vidalperezbohoyo/g-arm/documentation/electronics.png

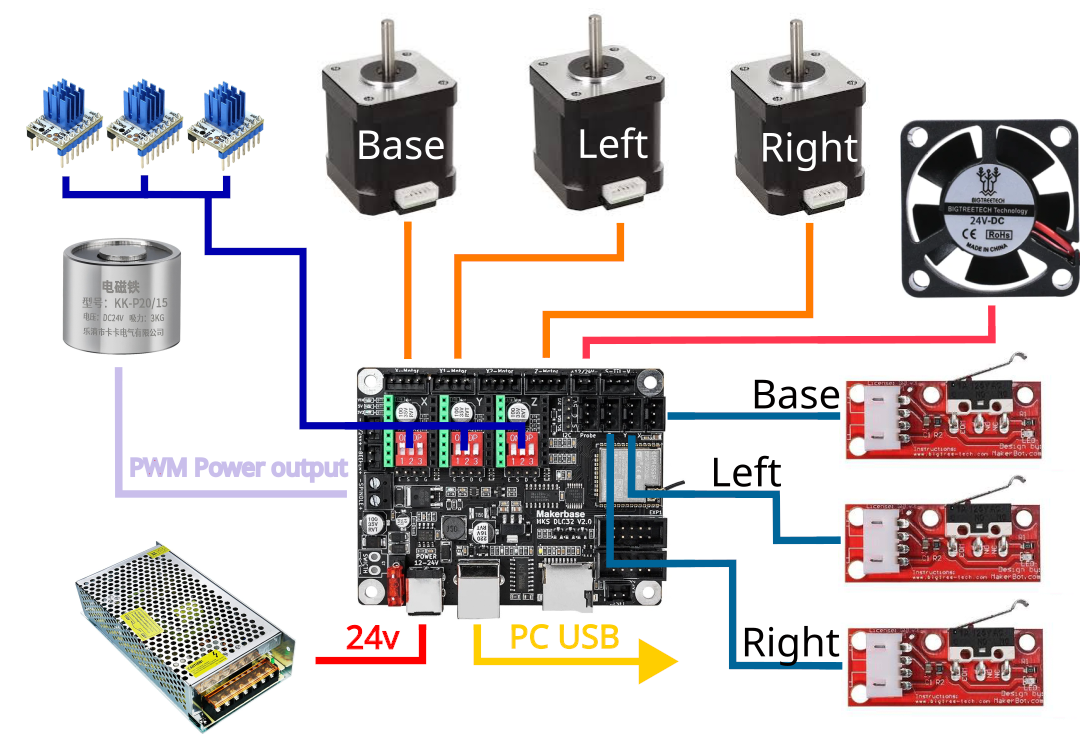
documentation/electronics.png
