vidalperezbohoyo/g-arm/documentation/motors_names.png

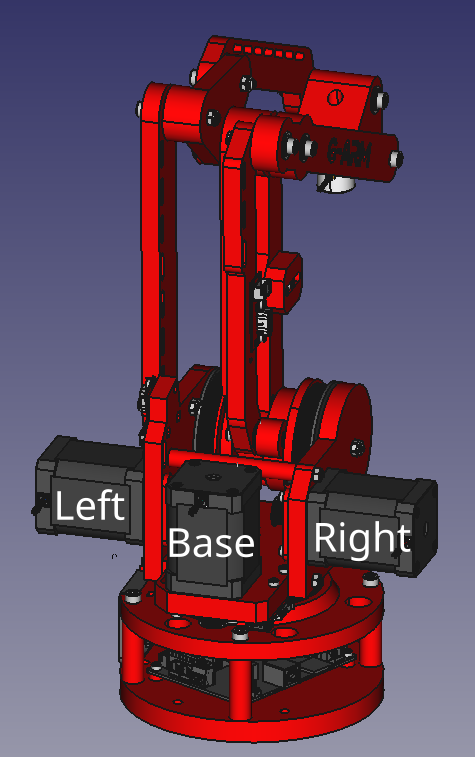
documentation/motors_names.png
