vidalperezbohoyo/g-arm/documentation/wiki_images/trajectories.png

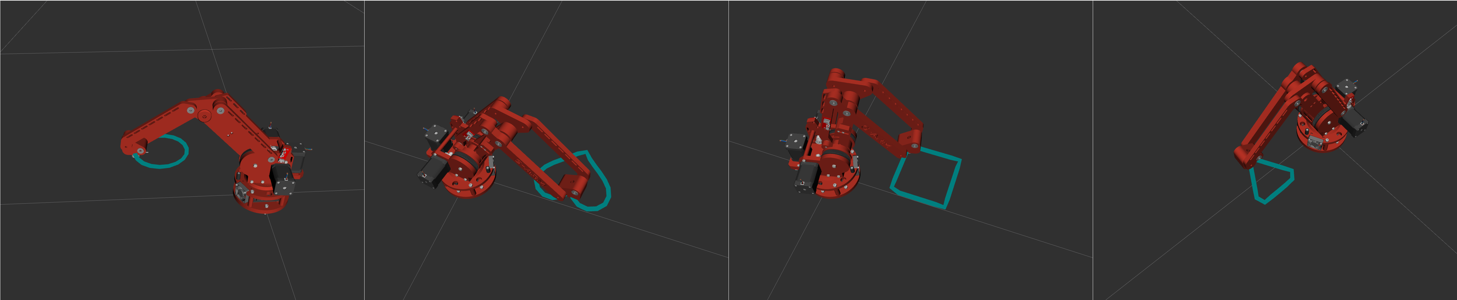
documentation/wiki_images/trajectories.png
