vidalperezbohoyo/g-arm/hardware/FreeCad/#0_ASSEMBLY_ELECTROMAGNET.FCStd

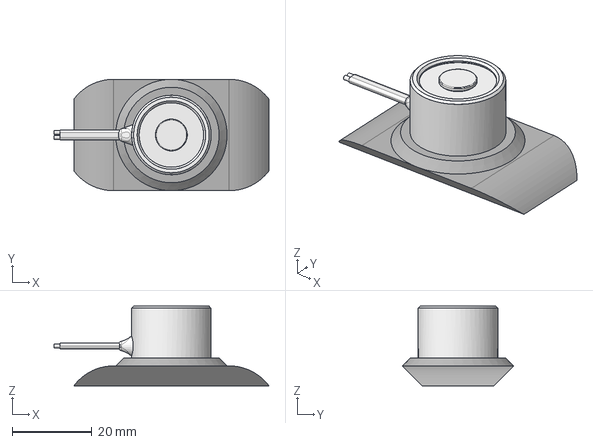
[picture p10: CAD file, 2026-05-24]
hardware/FreeCad/#0_ASSEMBLY_ELECTROMAGNET.FCStd
54.0 x 28.0 x 20.0 mm
#23_TOOL_Electromagnet_001
electromagnet1_001
