vidalperezbohoyo/g-arm/hardware/FreeCad/#0_ASSEMBLY_MAIN_BASE.FCStd

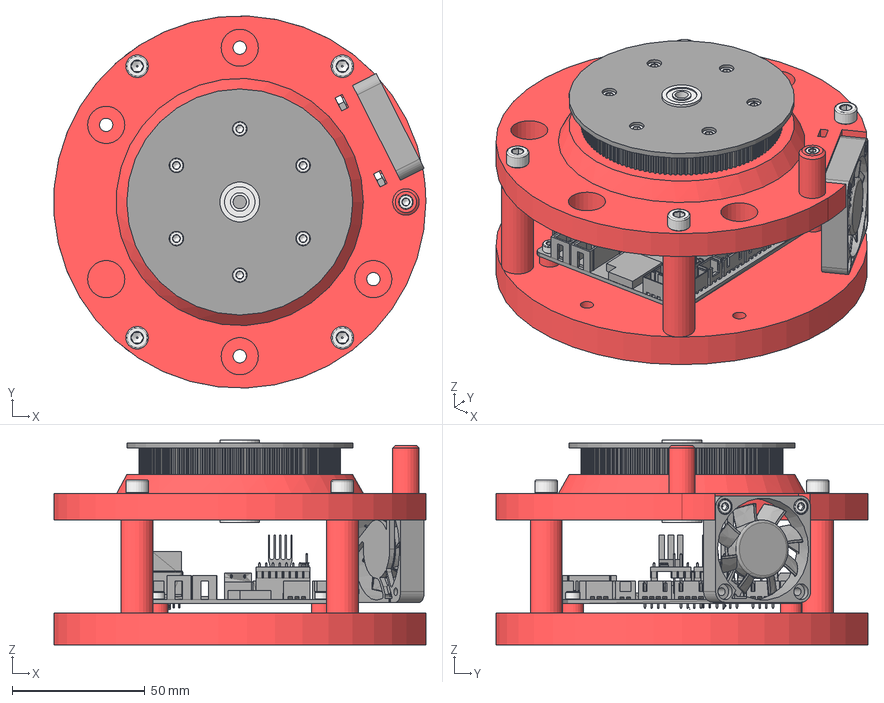
[picture p11: CAD file, 2026-05-24]
hardware/FreeCad/#0_ASSEMBLY_MAIN_BASE.FCStd
139.8 x 139.9 x 77.0 mm
#1_BaseFloor_001
#2_BaseSpacers_001
#3_BaseTop_001
#2_BaseSpacers_002
#2_BaseSpacers_003
#2_BaseSpacers_004
4010Fan
#4_BasePulley120T_001
M3x25-Tornillo
M3x25-Tornillo018
M3x25-Tornillo019
M3x25-Tornillo020
M3x25-Tornillo021
M3x25-Tornillo022
M5x50-Tornillo
M5x50-Tornillo007
M5x50-Tornillo008
M5x50-Tornillo009
M3x16-Tornillo
M3x16-Tornillo001
#6_BaseRotationLimit_001
M3x25-Tornillo023
Mks1_001
F6951_001
F6951_002
M3x12-Tornillo
M3x12-Tornillo013
M3x12-Tornillo014
M3x12-Tornillo015
M3-Tuerca
M3-Tuerca001
M3-Tuerca002
M3-Tuerca003
M3-Tuerca004
M3-Tuerca005
M3-Tuerca006
M3-Tuerca015
M3-Tuerca016
