vidalperezbohoyo/g-arm/hardware/FreeCad/#0_ASSEMBLY_END_EFFECTOR.FCStd

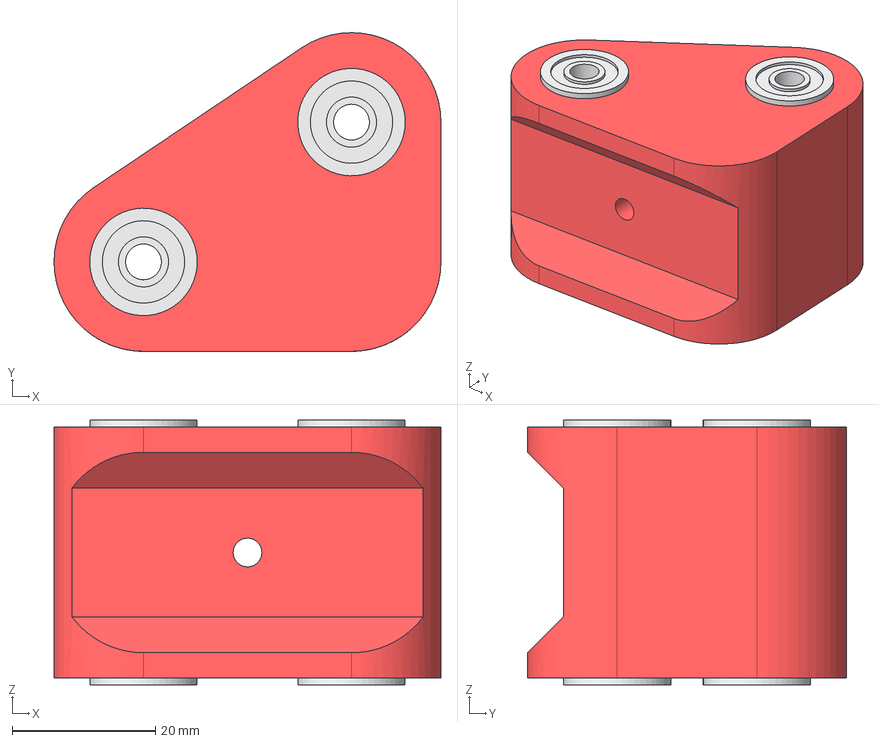
[picture p14: CAD file, 2026-05-24]
hardware/FreeCad/#0_ASSEMBLY_END_EFFECTOR.FCStd
54.1 x 44.5 x 37.0 mm
#21_EndEffector_001
F6951_001
F6951_002
F6951_003
F6951_004
