vidalperezbohoyo/g-arm/hardware/Complements/F695.step

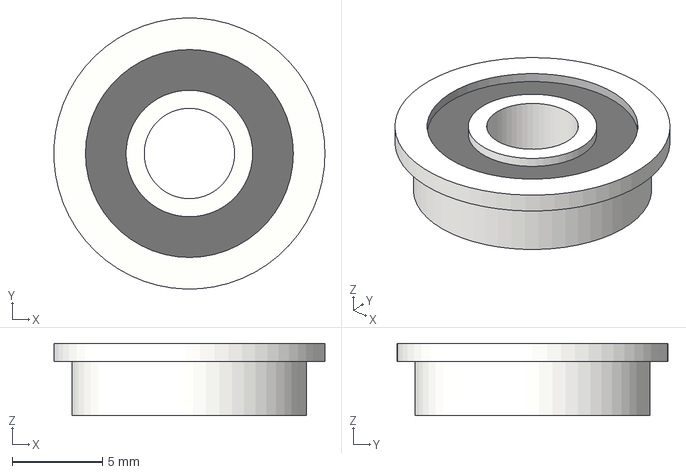
[picture p15: CAD file, 2023-10-28]
hardware/Complements/F695.step
15.0 x 15.0 x 4.00 mm
