vidalperezbohoyo/g-arm/hardware/FreeCad/#20_Link2Parallel.FCStd

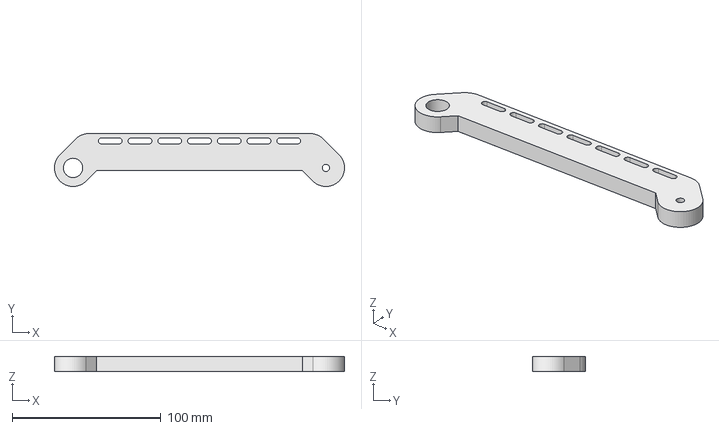
[picture p16: CAD file, 2026-05-24]
hardware/FreeCad/#20_Link2Parallel.FCStd
195.0 x 35.6 x 10.0 mm
