vidalperezbohoyo/g-arm/ros2/g_arm_description/meshes/link_j3_lever.stl

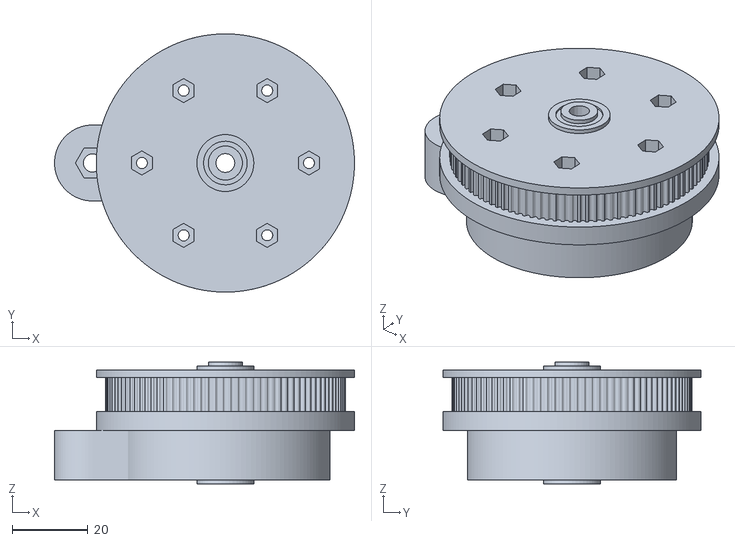
[picture p17: CAD file, 2023-10-28]
ros2/g_arm_description/meshes/link_j3_lever.stl
79.0 x 68.0 x 32.0
