vidalperezbohoyo/g-arm/hardware/Complements/GT2_20T.step

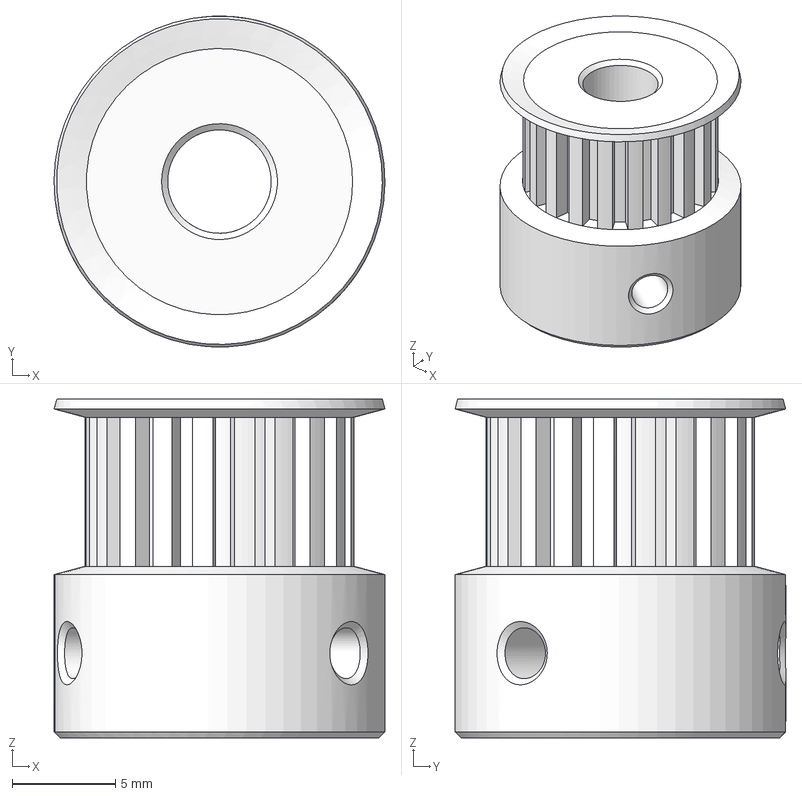
[picture p18: CAD file, 2023-10-28]
hardware/Complements/GT2_20T.step
16.0 x 16.0 x 16.4 mm
