vidalperezbohoyo/g-arm/hardware/FreeCad/#11_Link1.FCStd

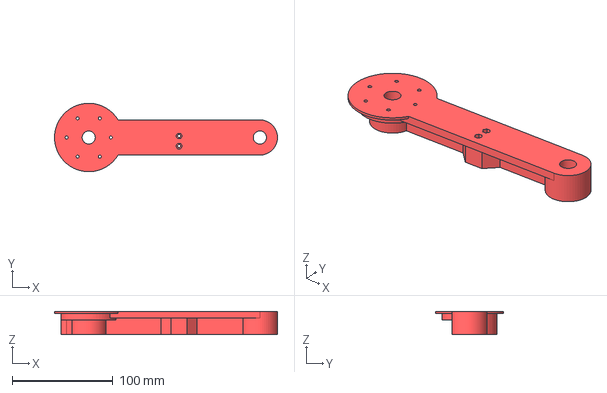
[picture p19: CAD file, 2026-05-24]
hardware/FreeCad/#11_Link1.FCStd
221.5 x 67.9 x 23.0 mm
