vidalperezbohoyo/g-arm/ros2/g_arm_description/meshes/link1.stl

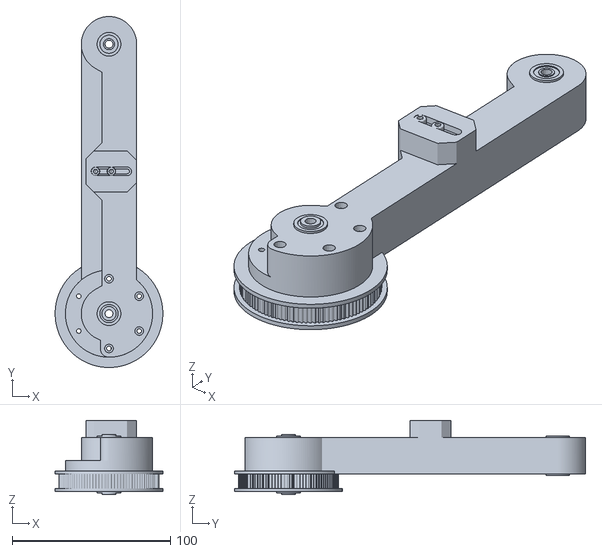
[picture p20: CAD file, 2023-10-28]
ros2/g_arm_description/meshes/link1.stl
68.0 x 221.5 x 47.0
