vidalperezbohoyo/g-arm/ros2/g_arm_description/meshes/link_j3_rod.stl

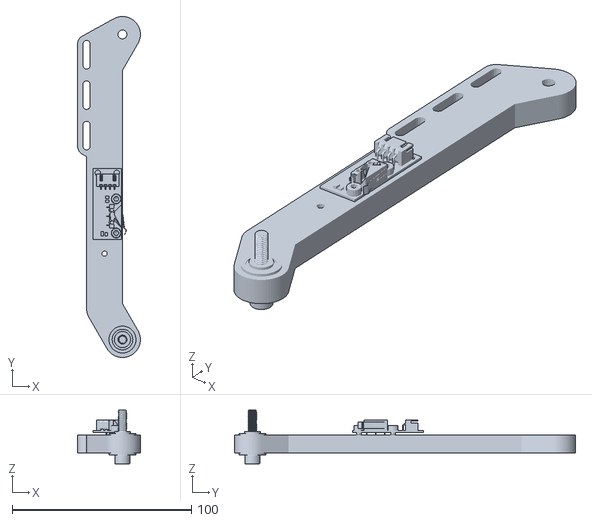
[picture p22: CAD file, 2023-10-28]
ros2/g_arm_description/meshes/link_j3_rod.stl
35.0 x 190.0 x 30.0
