vidalperezbohoyo/g-arm/hardware/Complements/Endstop.step

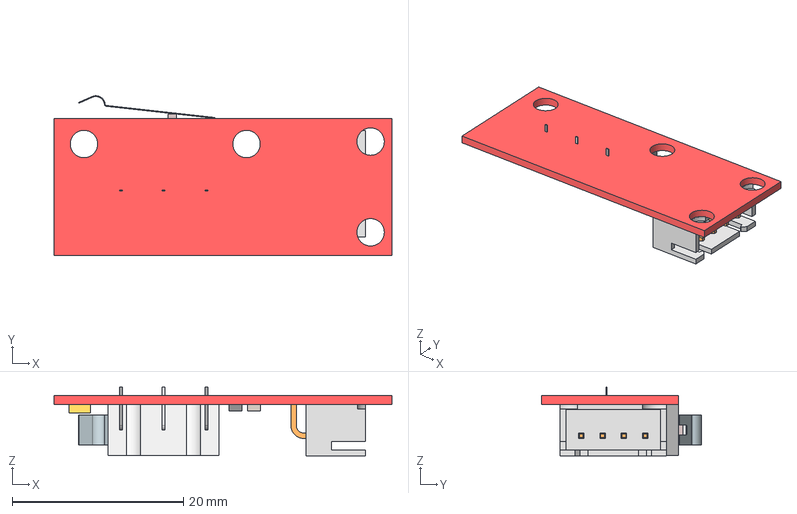
[picture p23: CAD file, 2023-10-28]
hardware/Complements/Endstop.step
39.5 x 18.6 x 8.02 mm
PCB Geometry
PCB^Endstop
Microswitch_1A_125vAC(seul)
JST 4Pin
