vidalperezbohoyo/g-arm/hardware/FreeCad/#17_Elbow.FCStd

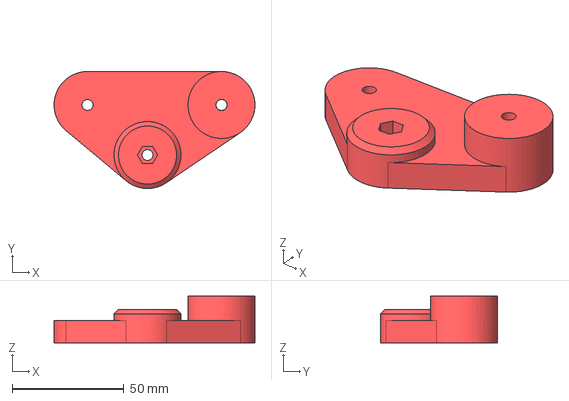
[picture p24: CAD file, 2026-05-24]
hardware/FreeCad/#17_Elbow.FCStd
90.0 x 52.4 x 21.0 mm
