vidalperezbohoyo/g-arm/ros2/g_arm_description/meshes/end.stl

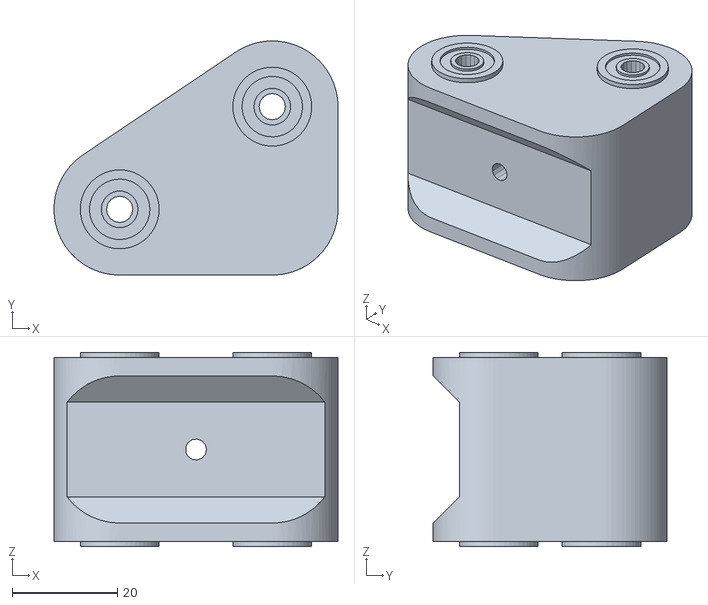
[picture p25: CAD file, 2023-10-28]
ros2/g_arm_description/meshes/end.stl
54.0 x 44.5 x 37.0
