vidalperezbohoyo/g-arm/hardware/Complements/electromagnet.step

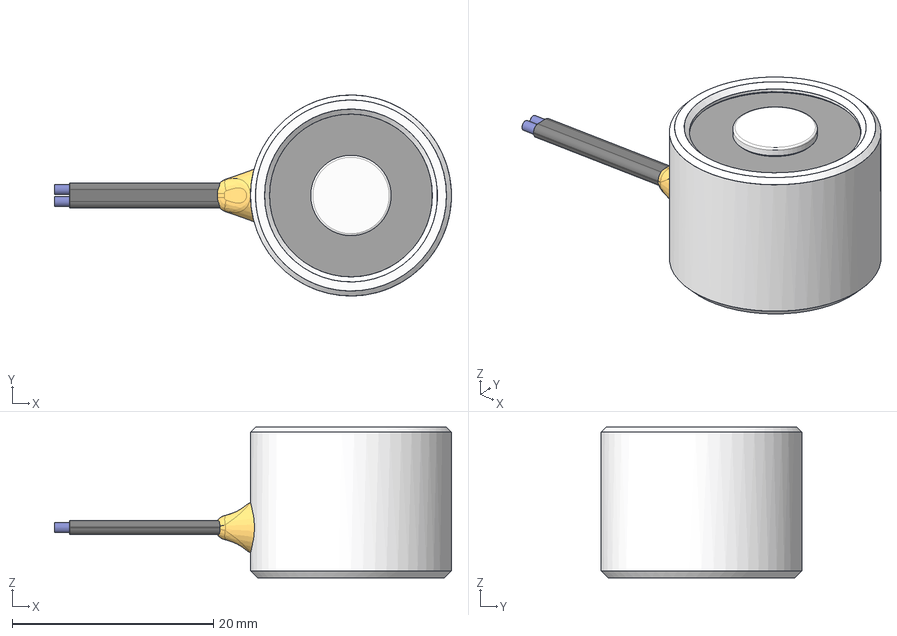
[picture p26: CAD file, 2023-10-28]
hardware/Complements/electromagnet.step
39.5 x 20.0 x 15.0 mm
cap
coil
shell_wire
wire_skin2
wire_skin1
wire1
wire2
glue
