vidalperezbohoyo/g-arm/hardware/FreeCad/#4_BasePulley120T.FCStd

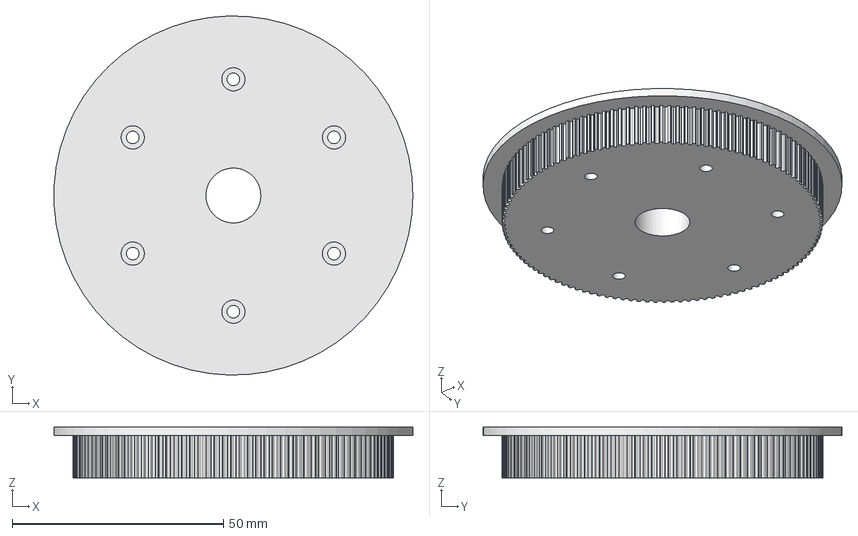
[picture p27: CAD file, 2026-05-24]
hardware/FreeCad/#4_BasePulley120T.FCStd
84.9 x 85.0 x 12.0 mm
