vidalperezbohoyo/g-arm/ros2/g_arm_description/meshes/parallel_end_link1.stl

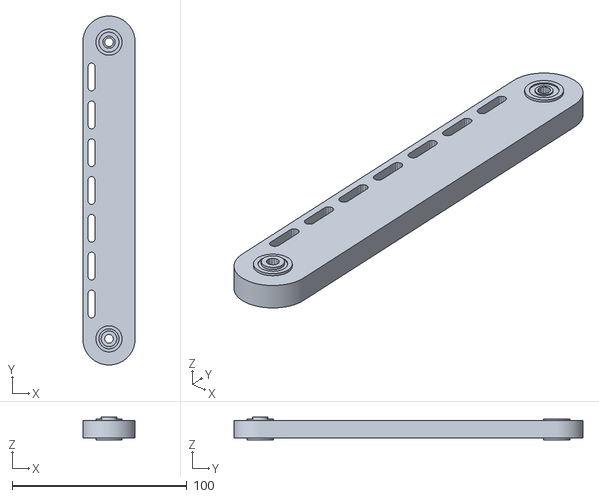
[picture p28: CAD file, 2023-10-28]
ros2/g_arm_description/meshes/parallel_end_link1.stl
30.0 x 200.0 x 13.0
