vidalperezbohoyo/g-arm/hardware/Complements/F623.step

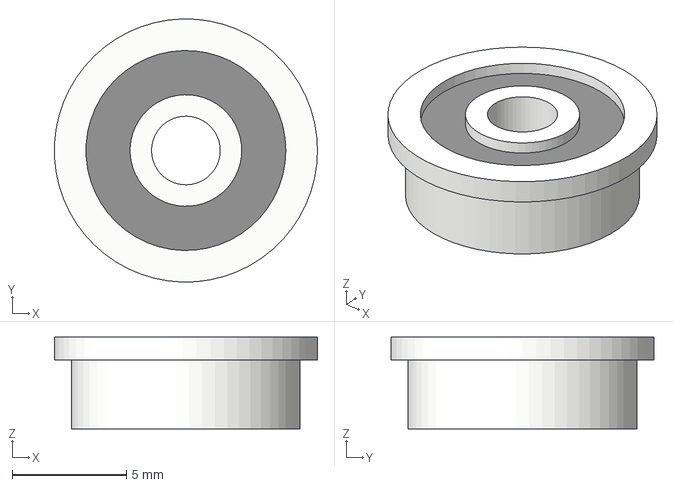
[picture p29: CAD file, 2023-10-28]
hardware/Complements/F623.step
11.5 x 11.5 x 4.00 mm
