vidalperezbohoyo/g-arm/ros2/g_arm_description/meshes/parallel_end_link2.stl

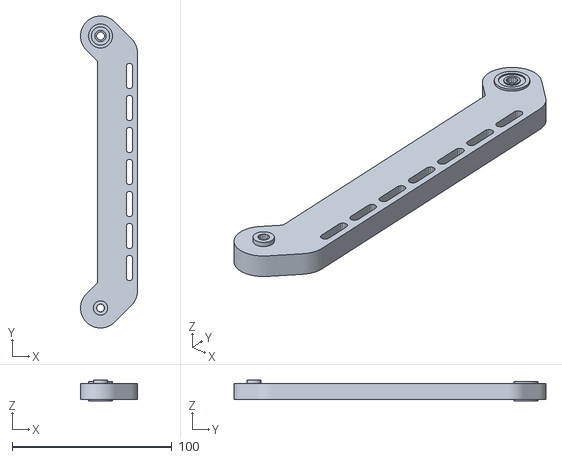
[picture p30: CAD file, 2023-10-28]
ros2/g_arm_description/meshes/parallel_end_link2.stl
35.6 x 195.0 x 13.0
