vidalperezbohoyo/g-arm/hardware/FreeCad/#9_PasiveBearingSpacer.FCStd

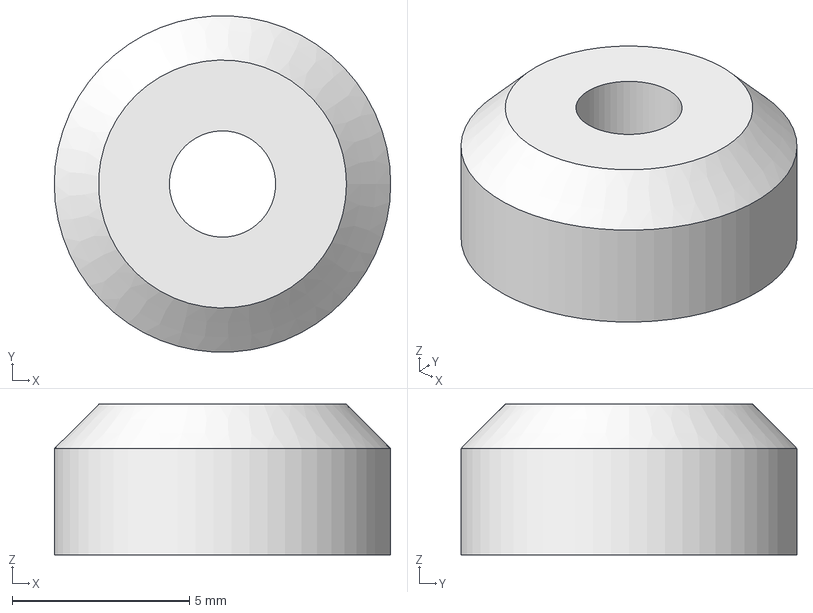
[picture p31: CAD file, 2026-05-24]
hardware/FreeCad/#9_PasiveBearingSpacer.FCStd
9.50 x 9.49 x 4.25 mm
