vidalperezbohoyo/g-arm/ros2/g_arm_description/meshes/elbow.stl

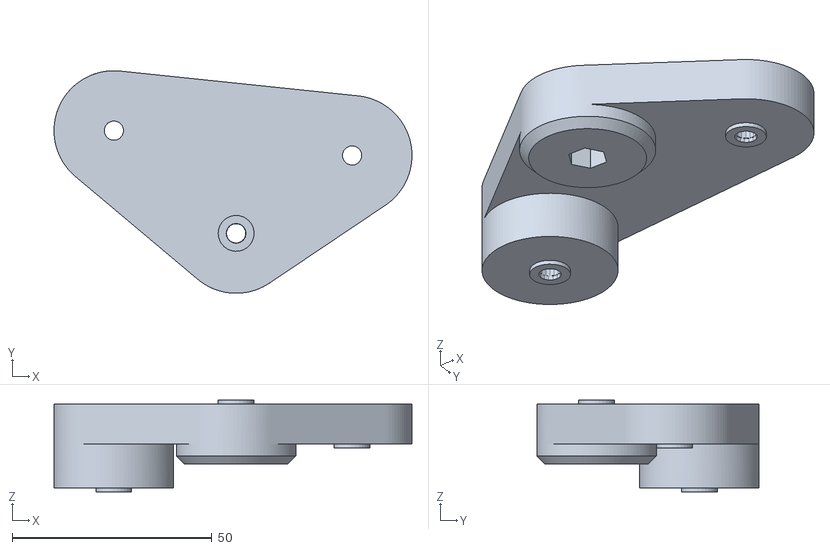
[picture p32: CAD file, 2023-10-28]
ros2/g_arm_description/meshes/elbow.stl
89.7 x 55.7 x 23.0
