vidalperezbohoyo/g-arm/ros2/g_arm_description/meshes/link2.stl

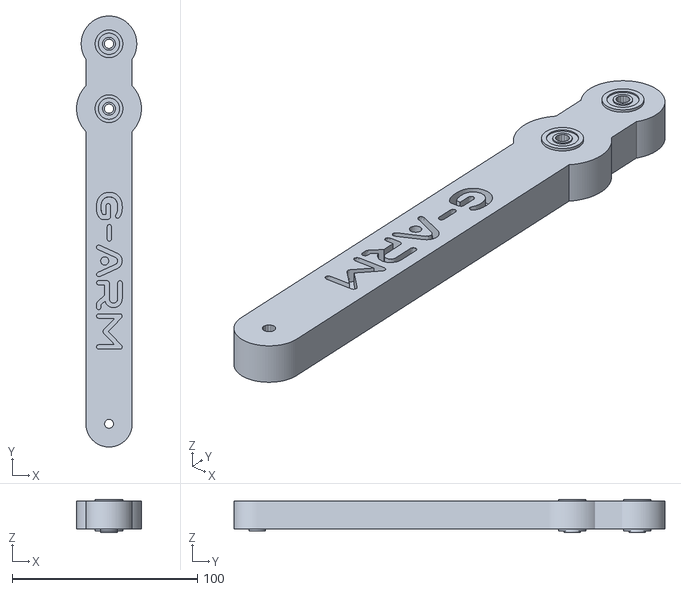
[picture p33: CAD file, 2023-10-28]
ros2/g_arm_description/meshes/link2.stl
35.0 x 232.5 x 18.0
