vidalperezbohoyo/g-arm/hardware/FreeCad/#1_BaseFloor.FCStd

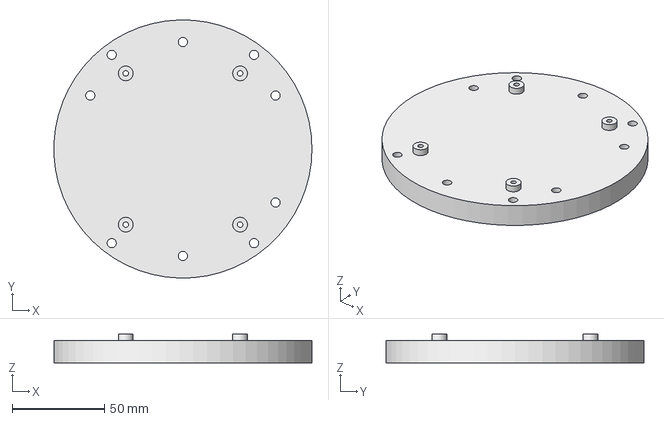
[picture p34: CAD file, 2026-05-24]
hardware/FreeCad/#1_BaseFloor.FCStd
139.9 x 140.0 x 15.5 mm
