vidalperezbohoyo/g-arm/hardware/FreeCad/#18_EndStopLink2Adjust.FCStd

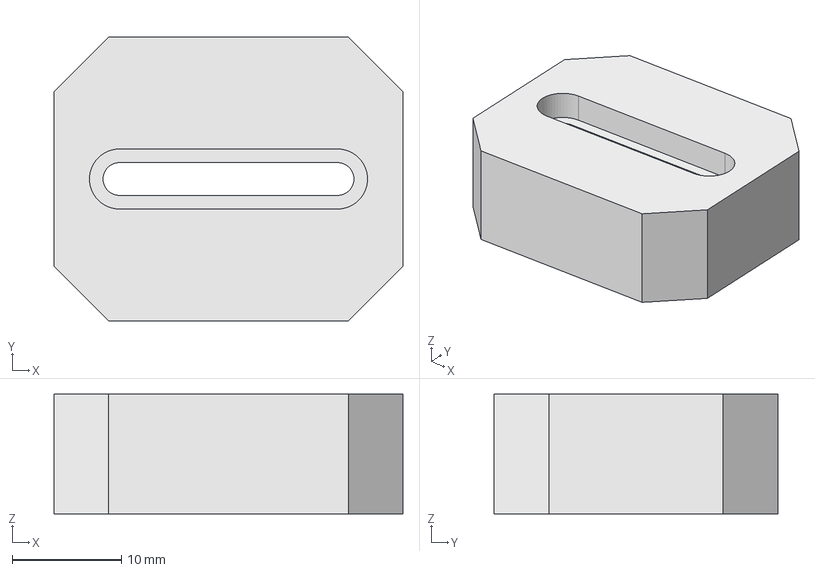
[picture p35: CAD file, 2026-05-24]
hardware/FreeCad/#18_EndStopLink2Adjust.FCStd
32.0 x 26.0 x 11.0 mm
