vidalperezbohoyo/g-arm/hardware/FreeCad/#12_MotorsBaseSpacer.FCStd

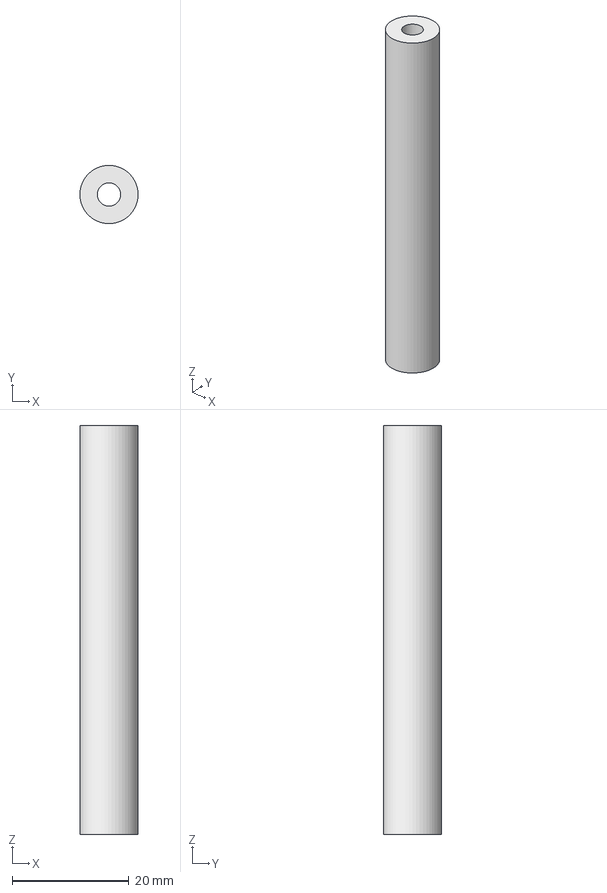
[picture p36: CAD file, 2026-05-24]
hardware/FreeCad/#12_MotorsBaseSpacer.FCStd
9.99 x 10.00 x 70.2 mm
