vidalperezbohoyo/g-arm/hardware/FreeCad/#6_BaseRotationLimit.FCStd

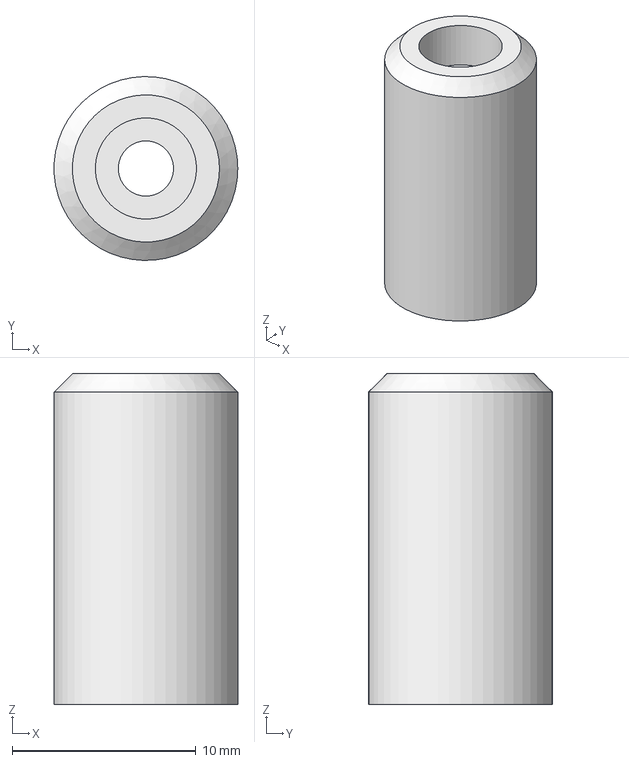
[picture p37: CAD file, 2026-05-24]
hardware/FreeCad/#6_BaseRotationLimit.FCStd
9.99 x 10.00 x 18.0 mm
