vidalperezbohoyo/g-arm/hardware/FreeCad/#14_Joint2Crank.FCStd

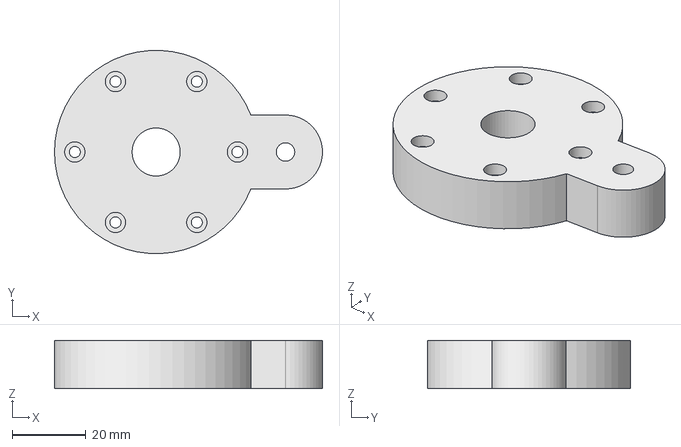
[picture p38: CAD file, 2026-05-24]
hardware/FreeCad/#14_Joint2Crank.FCStd
72.5 x 54.9 x 13.0 mm
