vidalperezbohoyo/g-arm/hardware/FreeCad/#23_TOOL_Electromagnet.FCStd

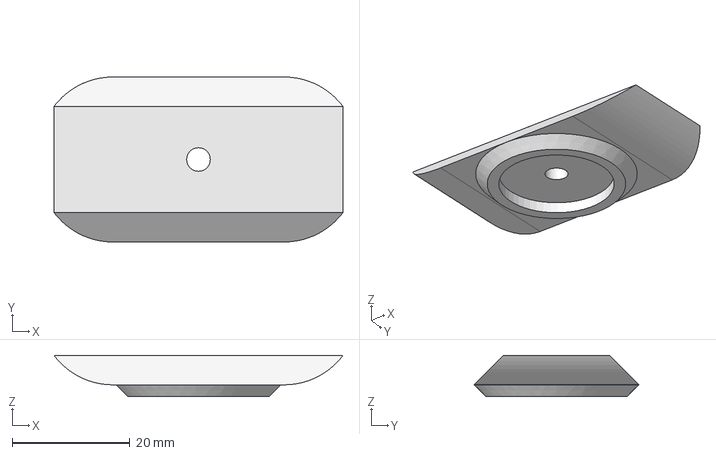
[picture p39: CAD file, 2026-05-24]
hardware/FreeCad/#23_TOOL_Electromagnet.FCStd
49.0 x 28.0 x 7.00 mm
