vidalperezbohoyo/g-arm/hardware/FreeCad/#16_EndEffectorParallel.FCStd

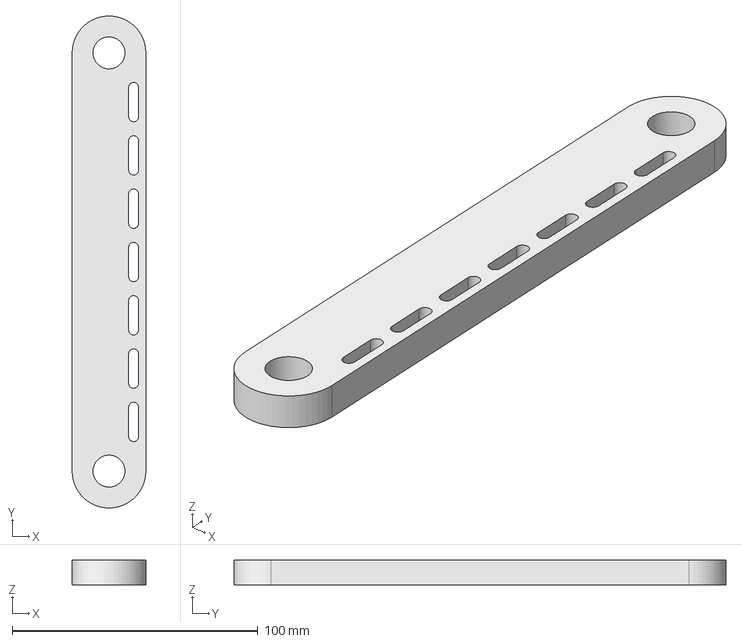
[picture p40: CAD file, 2026-05-24]
hardware/FreeCad/#16_EndEffectorParallel.FCStd
30.0 x 200.0 x 10.0 mm
