vidalperezbohoyo/g-arm/hardware/FreeCad/#15_Joint1Parallel.FCStd

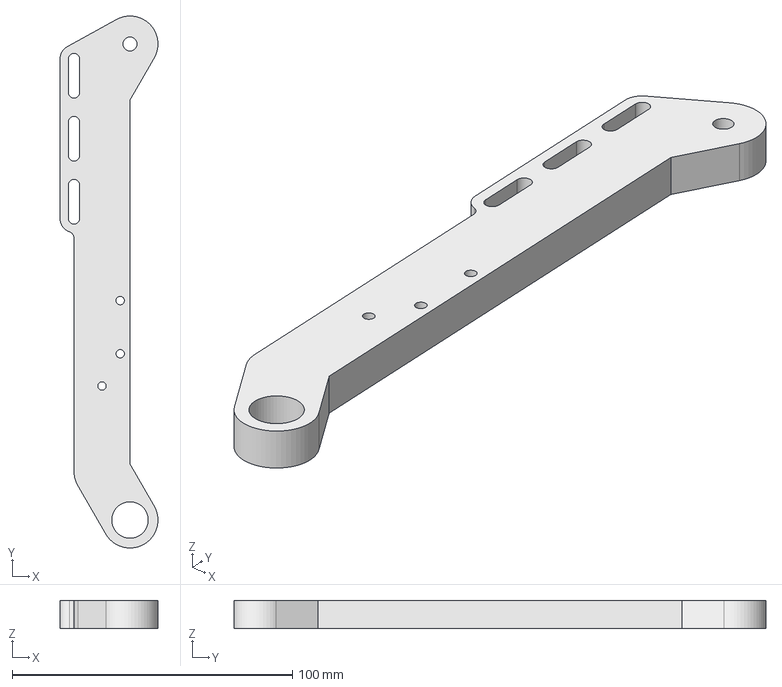
[picture p41: CAD file, 2026-05-24]
hardware/FreeCad/#15_Joint1Parallel.FCStd
35.0 x 190.0 x 10.0 mm
