vidalperezbohoyo/g-arm/hardware/FreeCad/#13_MotorsBasePulleyAntiSlip.FCStd

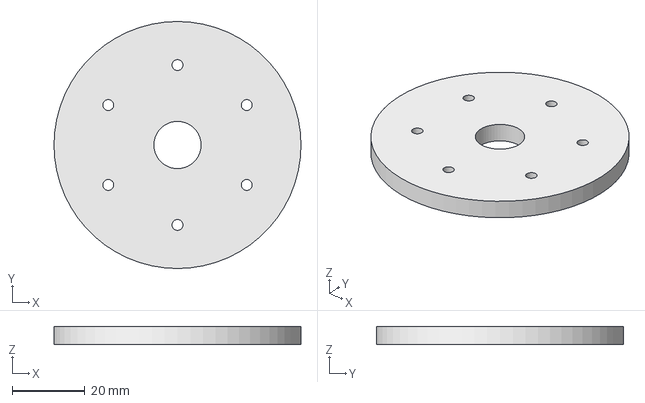
[picture p42: CAD file, 2026-05-24]
hardware/FreeCad/#13_MotorsBasePulleyAntiSlip.FCStd
68.0 x 68.0 x 5.00 mm
