vidalperezbohoyo/g-arm/hardware/FreeCad/#2_BaseSpacers.FCStd

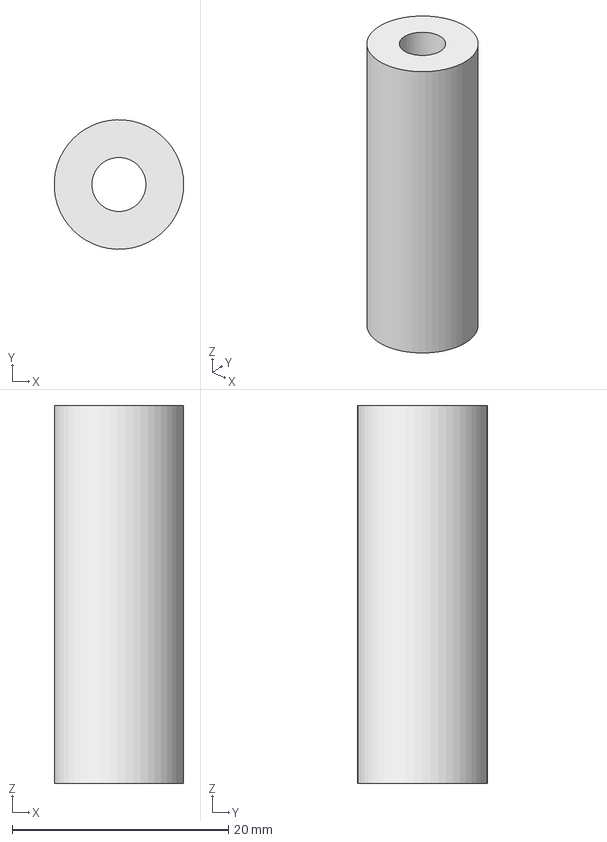
[picture p43: CAD file, 2026-05-24]
hardware/FreeCad/#2_BaseSpacers.FCStd
12.0 x 12.0 x 35.0 mm
