vidalperezbohoyo/g-arm/hardware/FreeCad/#8_MotorsPlateLeft.FCStd

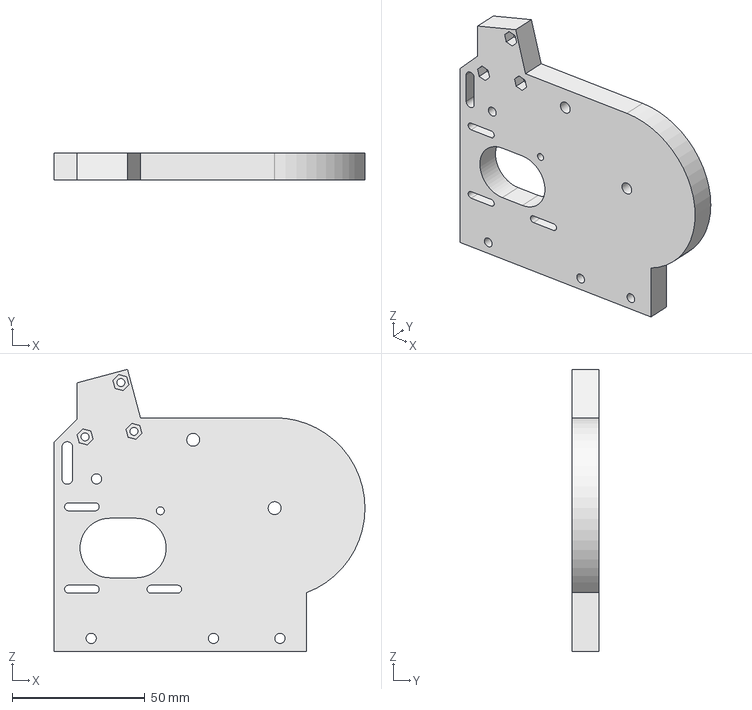
[picture p44: CAD file, 2026-05-24]
hardware/FreeCad/#8_MotorsPlateLeft.FCStd
117.0 x 10.0 x 106.2 mm
