vidalperezbohoyo/g-arm/hardware/FreeCad/#22_MotorsSlider.FCStd

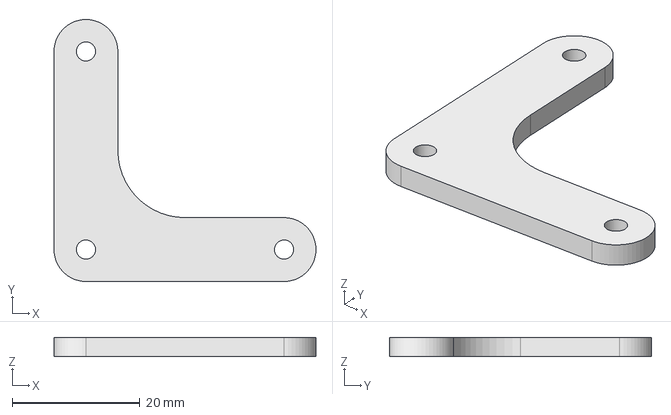
[picture p45: CAD file, 2026-05-24]
hardware/FreeCad/#22_MotorsSlider.FCStd
41.0 x 41.0 x 3.00 mm
