vidalperezbohoyo/g-arm/hardware/FreeCad/#10_MotorsBasePulleys.FCStd

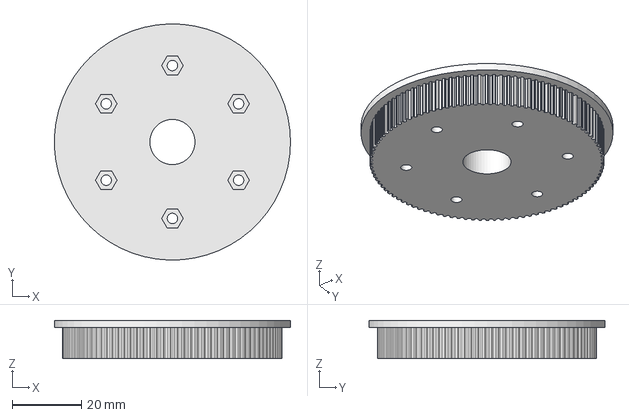
[picture p46: CAD file, 2026-05-24]
hardware/FreeCad/#10_MotorsBasePulleys.FCStd
68.0 x 68.0 x 11.0 mm
