vidalperezbohoyo/g-arm/hardware/FreeCad/#19_Link2.FCStd

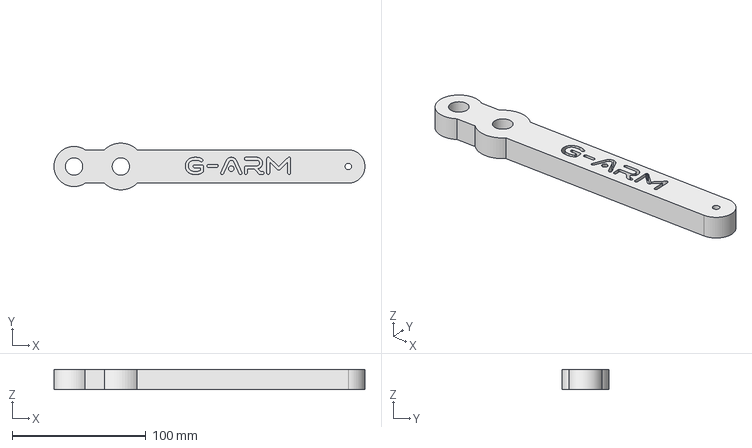
[picture p47: CAD file, 2026-05-24]
hardware/FreeCad/#19_Link2.FCStd
232.5 x 34.9 x 15.0 mm
