vidalperezbohoyo/g-arm/hardware/FreeCad/#5_MotorsBase.FCStd

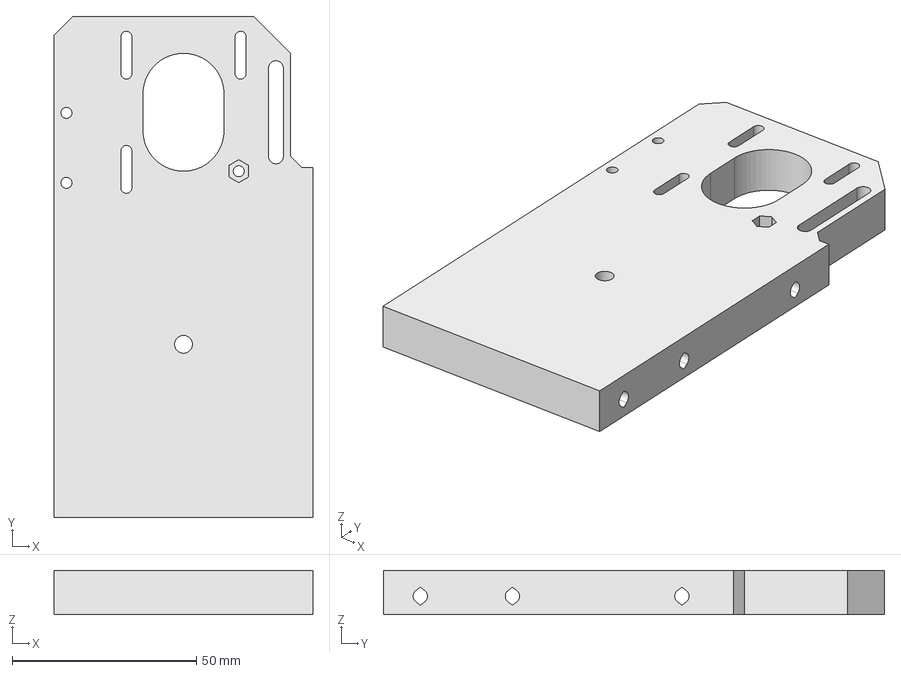
[picture p48: CAD file, 2026-05-24]
hardware/FreeCad/#5_MotorsBase.FCStd
70.2 x 136.0 x 12.0 mm
