vidalperezbohoyo/g-arm/hardware/FreeCad/#24_TOOL_Pen.FCStd

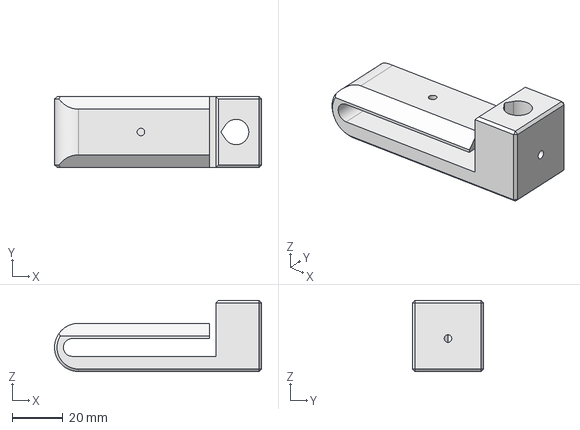
[picture p49: CAD file, 2026-05-24]
hardware/FreeCad/#24_TOOL_Pen.FCStd
81.5 x 28.0 x 28.0 mm
