vidalperezbohoyo/g-arm/hardware/FreeCad/#21_EndEffector.FCStd

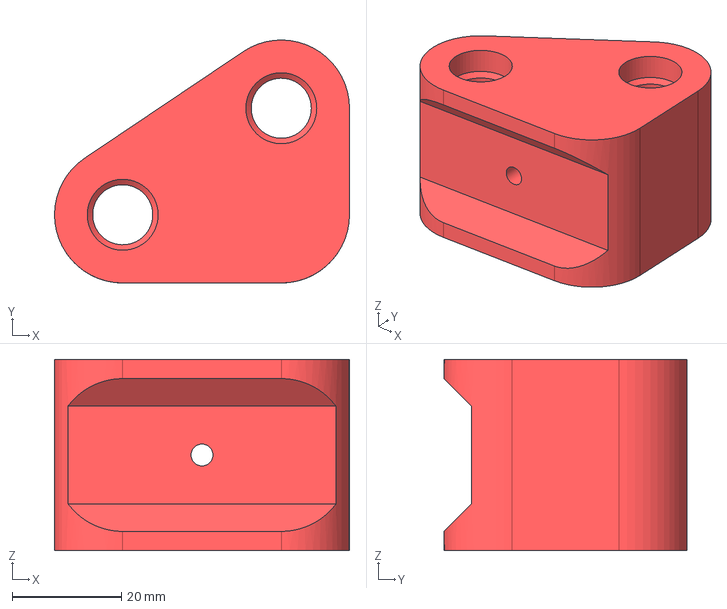
[picture p50: CAD file, 2026-05-24]
hardware/FreeCad/#21_EndEffector.FCStd
54.1 x 44.5 x 35.0 mm
