vidalperezbohoyo/g-arm/hardware/FreeCad/#7_MotorsPlateRight.FCStd

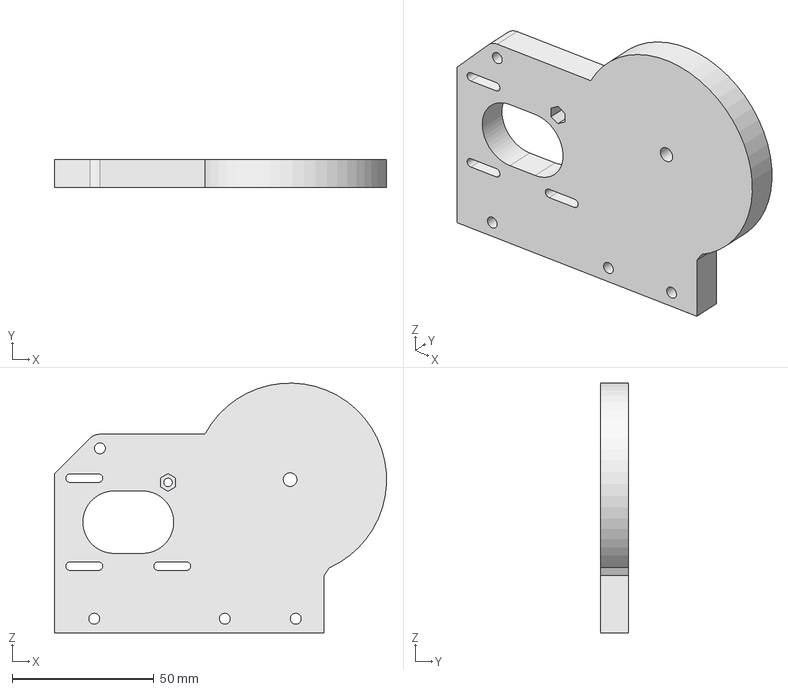
[picture p51: CAD file, 2026-05-24]
hardware/FreeCad/#7_MotorsPlateRight.FCStd
117.0 x 10.0 x 88.0 mm
