vidalperezbohoyo/g-arm/hardware/FreeCad/#3_BaseTop.FCStd

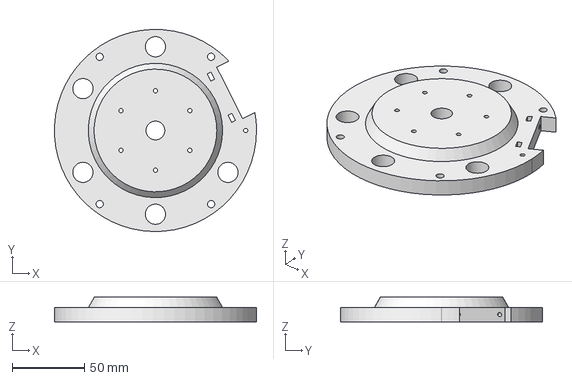
[picture p52: CAD file, 2026-05-24]
hardware/FreeCad/#3_BaseTop.FCStd
139.9 x 139.9 x 17.0 mm
