vidalperezbohoyo/g-arm/(list of files, cad)

Other CAD files:
hardware/AlambricModel.FCStd
