vidalperezbohoyo/g-arm/(commit log)

2023-10-28 Organised from my other repo
    [#0_ASSEMBLY_ELECTROMAGNET.FCStd, #0_ASSEMBLY_END_EFFECTOR.FCStd, #0_ASSEMBLY_LINKS.FCStd, #0_ASSEMBLY_MAIN_BASE.FCStd, #0_ASSEMBLY_MOTORS_BASE.FCStd, #10_MotorsBasePulleys.FCStd, #11_Link1.FCStd, #12_MotorsBaseSpacer.FCStd]
2023-10-28 Added GRBL config
    [GRBL_config.txt]
2023-11-19 Added piece 1 to 4 tech draws
    [#1_BaseFloor.FCStd, #2_BaseSpacers.FCStd, #3_BaseTop.FCStd, #4_BasePulley120T.FCStd]
2026-05-24 Added license to all FCSstd files with automatic script
    [#0_ASSEMBLY_ELECTROMAGNET.FCStd, #0_ASSEMBLY_END_EFFECTOR.FCStd, #0_ASSEMBLY_LINKS.FCStd, #0_ASSEMBLY_MAIN_BASE.FCStd, #0_ASSEMBLY_MOTORS_BASE.FCStd, #10_MotorsBasePulleys.FCStd, #11_Link1.FCStd, #12_MotorsBaseSpacer.FCStd]
